jurididevich/GyroCube/hardware/pcb/production/BOM_GyroCube_v1.csv

ID | Name | Designator | Footprint | Quantity | Manufacturer Part | Manufacturer | Supplier | Supplier Part | Price
1 | PIN-1.1 | J1,J1,J1 | HDR-M-2.54_1X10 | 3 |  |  | LCSC | C57369 | 0.064
2 | PIN-1.2 | J2,J2,J2 | HDR-M-2.54_1X10 | 3 |  |  | LCSC | C57369 | 0.064
3 | PIN-2.1 | J3,J3,J3 | HDR-M-2.54_1X10 | 3 |  |  | LCSC | C57369 | 0.064
4 | PIN-2.2 | J4,J4,J4 | HDR-M-2.54_1X10 | 3 |  |  | LCSC | C57369 | 0.064
5 | GY-91 | J5,J5,J5 | HDR-M-2.54_1X8 | 3 |  |  | LCSC | C190820 | 0.042
6 | 1x1 | J6,J6,J6 | HDR-M-2.54_1X1 | 3 |  |  | LCSC | C81276 | 0.009
7 | LED 3MM COMMON ANODE BICOLOR | LED1,LED1,LED1 | LED 3MM BI-COLOR COMMON ANODE | 3
8 | TP4056 MODULE | M1,M1,M1 | TP4056-MODULE | 3 |  | China |  | TP4056M
9 | 27k | R1,R1,R1 | RESISTOR-SMD | 3 | RESISTOR-SMD
10 | 100k | R2,R2,R2 | RESISTOR-SMD | 3 | RESISTOR-SMD
11 | 560 | R3,R3,R3 | RESISTOR-SMD | 3 | RESISTOR-SMD
12 | PS-5850 | SW1,SW1,SW1 | SW-TH_6P-L5.8-W5.8-P2.00-LS4.5-BL | 3 | PS-5850A-6PL | G-Switch | LCSC | C963201 | 0.201
13 | KLS7 | U1,U1,U1 | KLS7-TS6601 | 3 | KLS7-TS6601 |  |  | KLS7-TS6601
