jurididevich/GyroCube/hardware/mechanical/stl/NN.2023.002.004_Vibration_Isolation_Platform_v5.stl

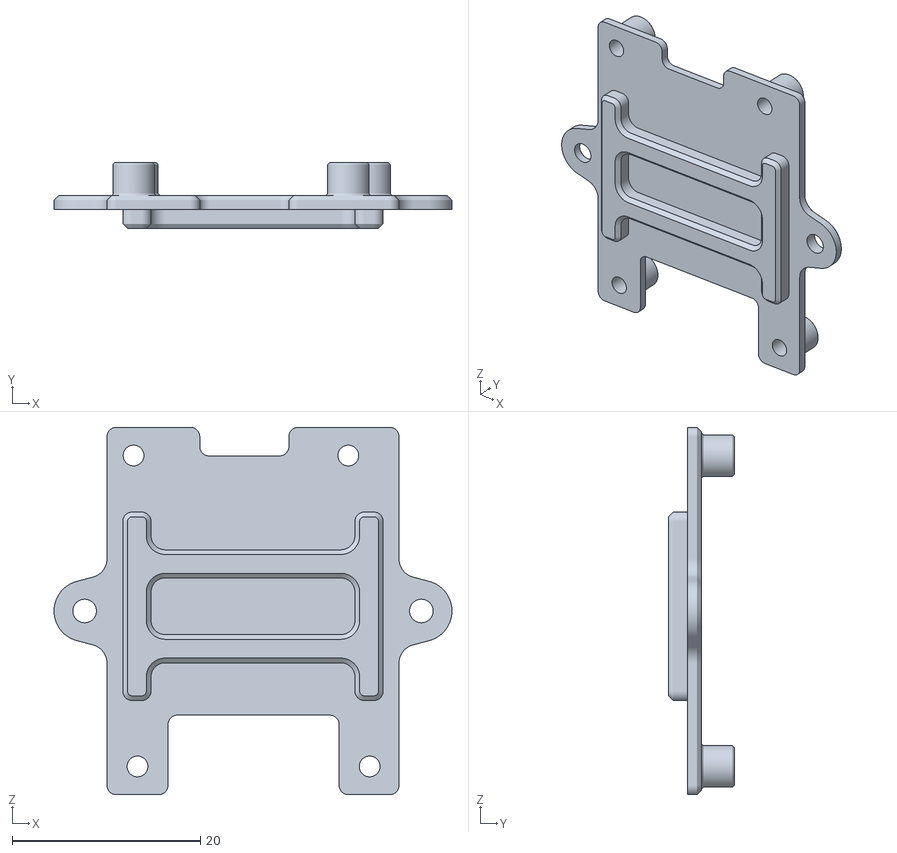
[picture p13: CAD file, 2026-08-30]
hardware/mechanical/stl/NN.2023.002.004_Vibration_Isolation_Platform_v5.stl
42.2 x 7.00 x 39.0
