jurididevich/GyroCube/hardware/pcb/schematics/Schematic_GyroCubeESP32_2023.pdf

## GyroCube Neurotafl

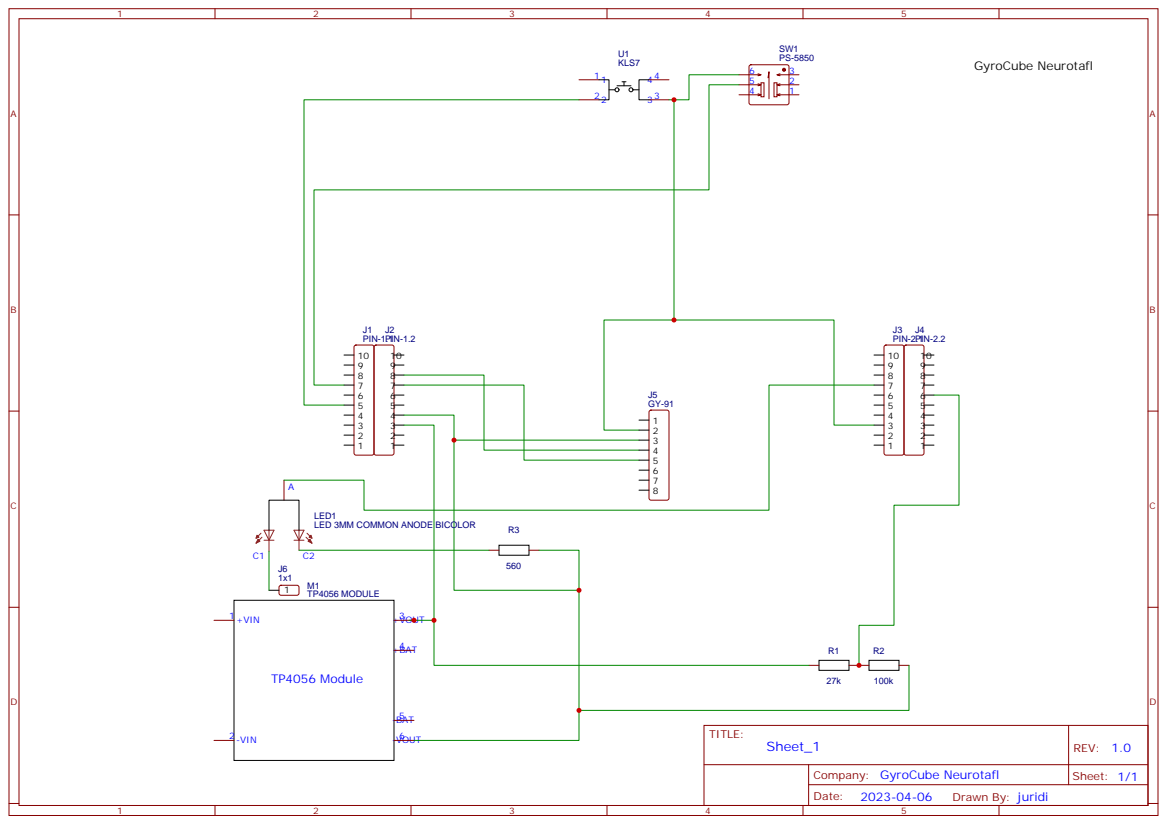
[picture p14: page 1]

LED1
LED 3MM COMMON ANODE BICOLOR
