jurididevich/GyroCube/(commit log)

2026-02-03 Initial Release
    [BOM_GyroCube_v1.csv, mc-helpconfig.txt, zl-helpconfig.txt]
2026-02-03 Reorder images in README for PCB and case assembly
2026-02-03 Add prototype gallery to README
    Added a prototype gallery section with images of various prototypes and components.
2026-02-03 Update README with prototype gallery and section titles
2026-02-03 Add 8 prototype photos
2026-02-03 Revise prototype gallery layout and image dimensions
    Updated image sizes in the prototype gallery and modified table headers for clarity.
2026-08-30 Add v2 firmware features, receiver/Unity apps, and 3D-printable case STLs
    Merge battery monitoring, status LED, configurable Kalman filter, and raw
    IMU streaming from the latest archived firmware into GyroCube_v1, on top
    of the existing EEPROM/UDP bug fixes. Add the archived standalone Windows
    receiver and Unity companion project, plus EEPROMEraser/I2CScanner utility
    sketches. Add case and vibration-isolation-platform STL files referenced
    by the README's fabrication section. All Russian comments and filenames
    in the transferred material translated to English.
    [NN.2023.002.004_Vibration_Isolation_Platform_v5.stl]
